AvalonSemiconductors/ci2406-bringup/README.md

# ci2406-bringup
Bring-up of CI2406 multi-project die.

[Documentation](https://avalonsemiconductors.github.io/CI2406/index.html)

[Tapeout repo](https://github.com/rejunity/ci2406-rej-pommedeterrible-tholin)
