AvalonSemiconductors/ci2406-bringup/AS1802/TestBoard/TestBoard.kicad_pcb

## KiCad design AS1802/TestBoard/TestBoard.kicad_pcb (2025-08-11)

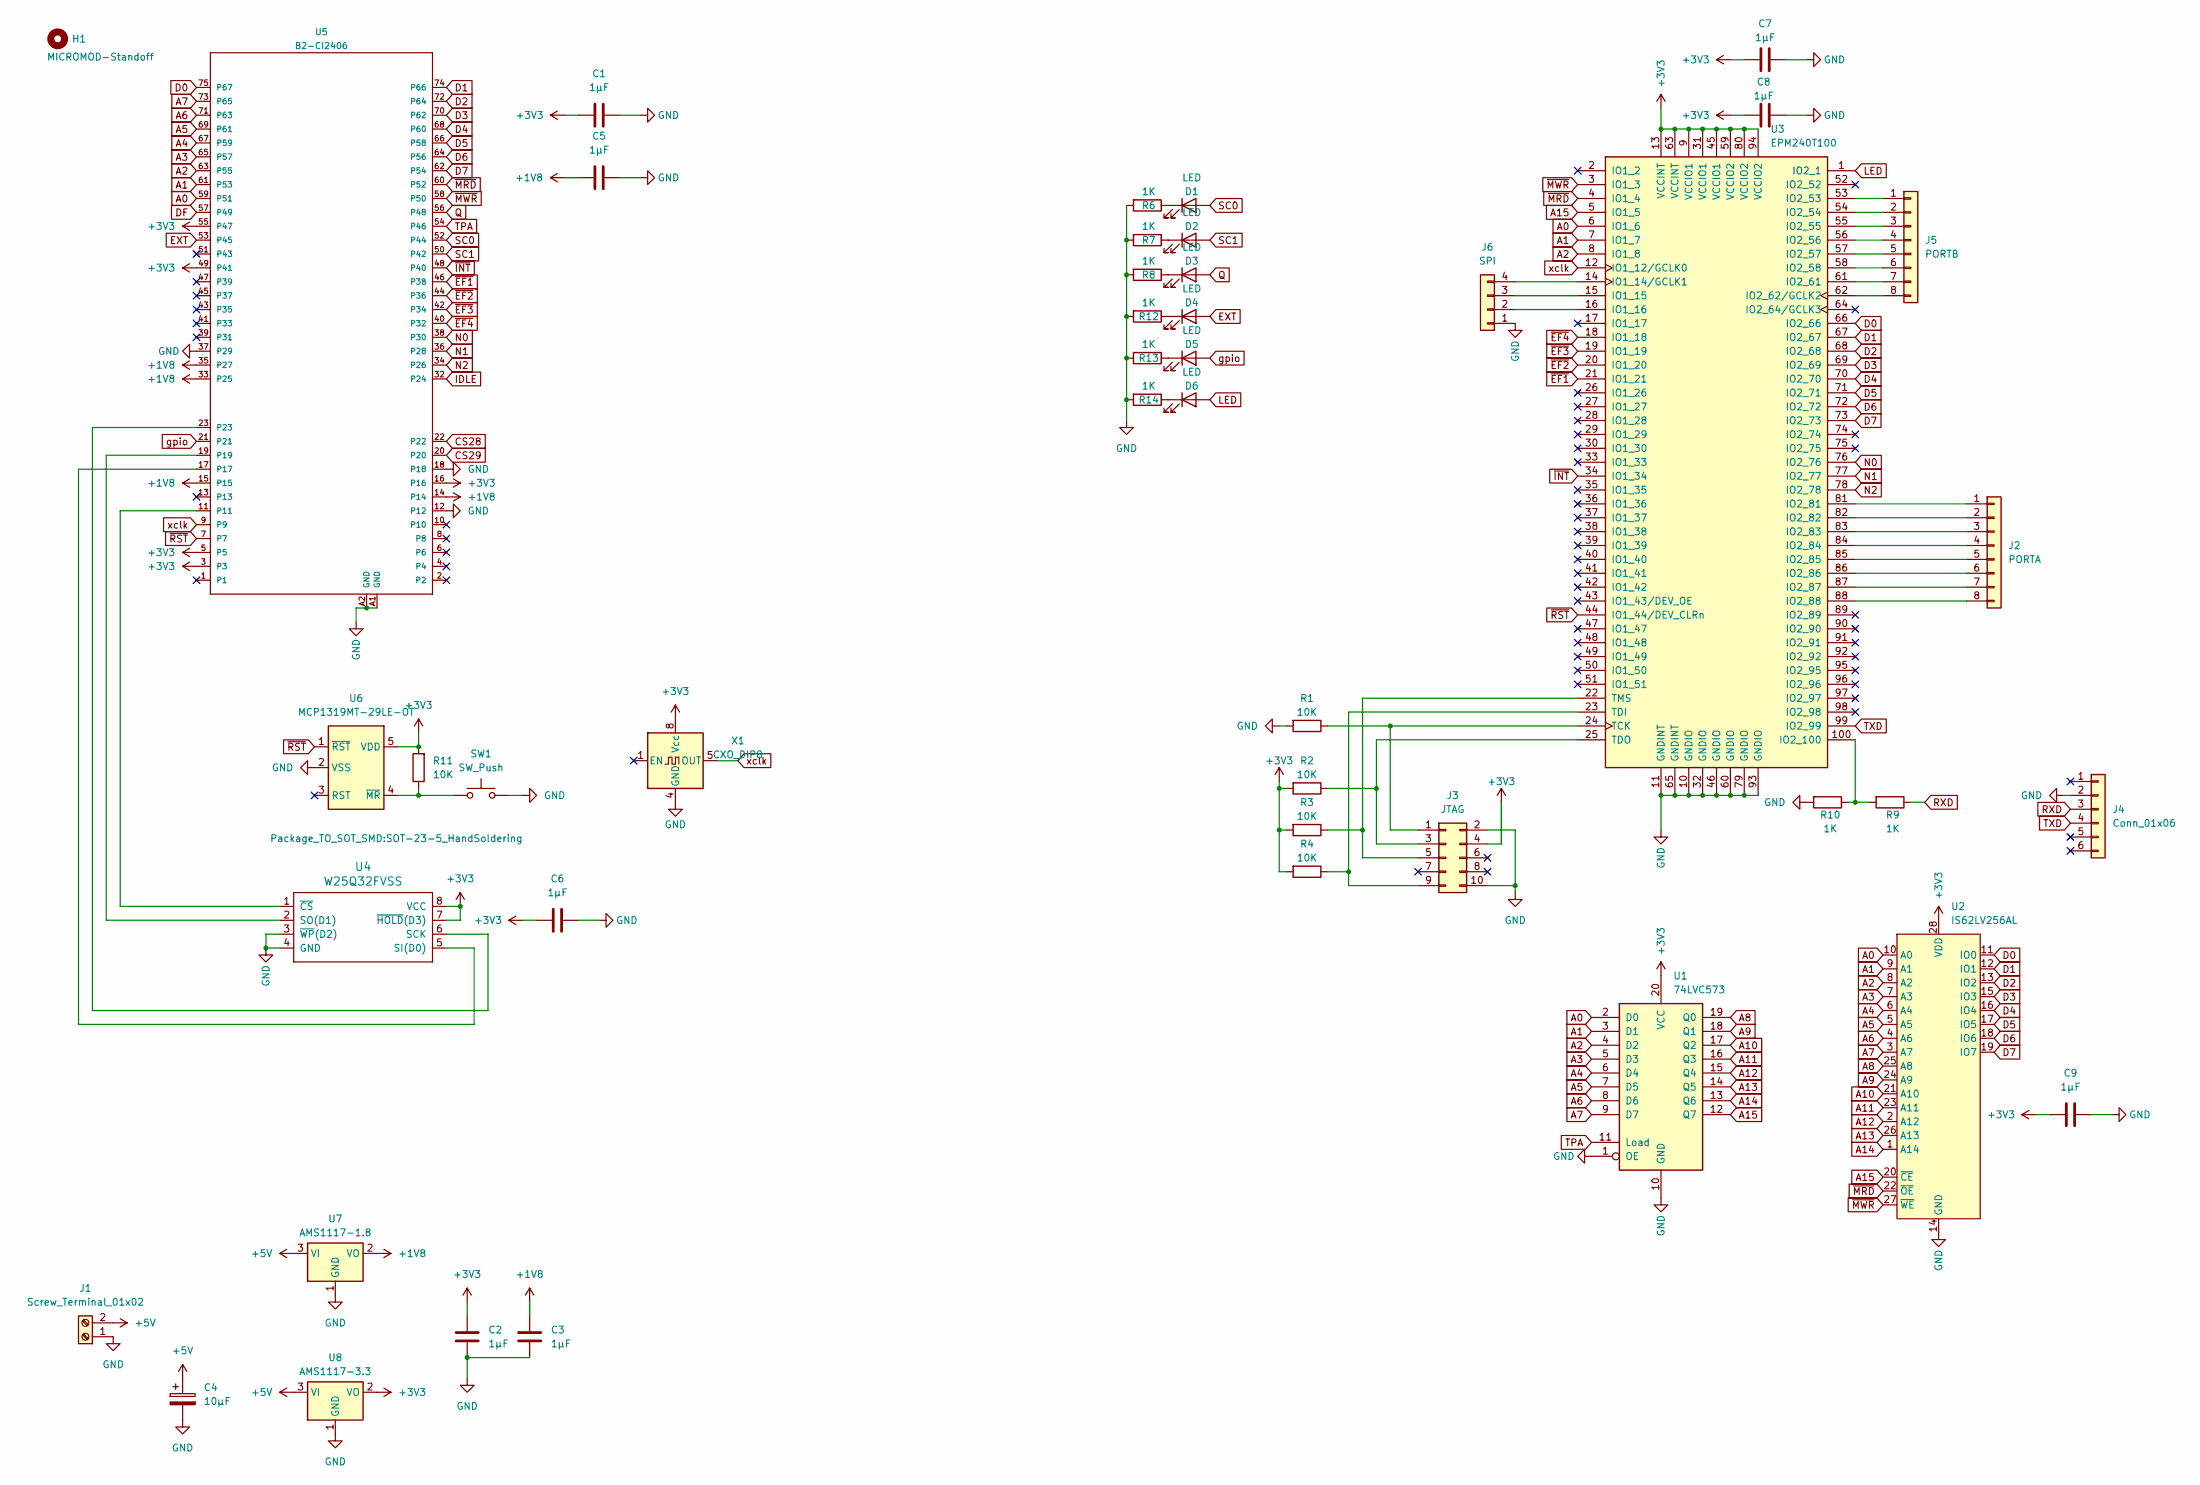
[picture p3: schematic TestBoard.kicad_sch]

Parts:
C1, C2, C3, C5, C6, C7, C8, C9: 1µF; C_0805_2012Metric_Pad1.18x1.45mm_HandSolder
C4: 10µF; CP_Radial_D4.0mm_P2.00mm
D1, D2, D3, D4, D5, D6: LED; LED_1206_3216Metric_Pad1.42x1.75mm_HandSolder
H1: MICROMOD-Standoff; MicroMod-Standoff
J1: Screw_Terminal_01x02; TerminalBlock_bornier-2_P5.08mm
J2: PORTA; PinHeader_1x08_P2.54mm_Vertical
J3: JTAG; PinHeader_2x05_P2.54mm_Vertical
J4: Conn_01x06; PinSocket_1x06_P2.54mm_Vertical
J5: PORTB; PinHeader_1x08_P2.54mm_Vertical
J6: SPI; PinHeader_1x04_P2.54mm_Vertical
R1, R2, R3, R4, R11: 10K; R_1206_3216Metric_Pad1.30x1.75mm_HandSolder
R6, R7, R8, R9, R10, R12, R13, R14: 1K; R_1206_3216Metric_Pad1.30x1.75mm_HandSolder
SW1: SW_Push; SW_PUSH_6mm
U1: 74LVC573; SO-20_12.8x7.5mm_P1.27mm
U2: IS62LV256AL; TSOP-I-28_11.8x8mm_P0.55mm-weird-pin-order
U3: EPM240T100; LQFP-100_14x14mm_P0.5mm
U4: W25Q32FVSS; DIP-8_W7.62mm; Part # W25Q32JVSSIQ
U5: B2-CI2406; M.2-CONNECTOR-E
U6: MCP1319MT-29LE-OT; SOT-23-5_HandSoldering
U7: AMS1117-1.8; SOT-223-3_TabPin2
U8: AMS1117-3.3; SOT-223-3_TabPin2
X1: CXO_DIP8; Oscillator_DIP-8

Connections:
+1V8: C3.2, C5.1, U5.14, U5.15, U5.33 (P25), U5.35 (P27), U7.2 (VO)
+3V3: C1.1, C2.2, C6.1, C7.1, C8.1, C9.1, J3.4, R2.2, R3.2, R4.2, R11.2, U1.20 (VCC), U2.28 (VDD), U3.9 (VCCIO1), U3.13 (VCCINT), U3.31 (VCCIO1), U3.45 (VCCIO1), U3.59 (VCCIO2), U3.63 (VCCINT), U3.80 (VCCIO2), U3.94 (VCCIO2), U4.7 (~HOLD(D3)), U4.8 (VCC), U5.3, U5.5, U5.16, U5.49 (P41), U5.55 (P47), U6.5 (VDD), U8.2 (VO), X1.8 (Vcc)
+5V: C4.1, J1.2, U7.3 (VI), U8.3 (VI)
A0: U1.2 (D0), U2.10 (A0), U3.6 (IO1_6), U5.59 (P51)
A1: U1.3 (D1), U2.9 (A1), U3.7 (IO1_7), U5.61 (P53)
A2: U1.4 (D2), U2.8 (A2), U3.8 (IO1_8), U5.63 (P55)
A3: U1.5 (D3), U2.7 (A3), U5.65 (P57)
A4: U1.6 (D4), U2.6 (A4), U5.67 (P59)
A5: U1.7 (D5), U2.5 (A5), U5.69 (P61)
A6: U1.8 (D6), U2.4 (A6), U5.71 (P63)
A7: U1.9 (D7), U2.3 (A7), U5.73 (P65)
A8: U1.19 (Q0), U2.25 (A8)
A9: U1.18 (Q1), U2.24 (A9)
A10: U1.17 (Q2), U2.21 (A10)
A11: U1.16 (Q3), U2.23 (A11)
A12: U1.15 (Q4), U2.2 (A12)
A13: U1.14 (Q5), U2.26 (A13)
A14: U1.13 (Q6), U2.1 (A14)
A15: U1.12 (Q7), U2.20 (~CE), U3.5 (IO1_5)
CS28: U5.22
CS29: U5.20
D0: U2.11 (IO0), U3.66 (IO2_66), U5.75 (P67)
D1: U2.12 (IO1), U3.67 (IO2_67), U5.74 (P66)
D2: U2.13 (IO2), U3.68 (IO2_68), U5.72 (P64)
D3: U2.15 (IO3), U3.69 (IO2_69), U5.70 (P62)
D4: U2.16 (IO4), U3.70 (IO2_70), U5.68 (P60)
D5: U2.17 (IO5), U3.71 (IO2_71), U5.66 (P58)
D6: U2.18 (IO6), U3.72 (IO2_72), U5.64 (P56)
D7: U2.19 (IO7), U3.73 (IO2_73), U5.62 (P54)
DF: U5.57 (P49)
EXT: D4.2 (A), U5.53 (P45)
GND: C1.2, C2.1, C3.1, C4.2, C5.2, C6.2, C7.2, C8.2, C9.2, J1.1, J3.2, J3.10, J4.2, J6.1, R1.2, R6.2, R7.2, R8.2, R10.2, R12.2, R13.2, R14.2, SW1.2, U1.1 (OE), U1.10 (GND), U2.14 (GND), U3.10 (GNDIO), U3.11 (GNDINT), U3.32 (GNDIO), U3.46 (GNDIO), U3.60 (GNDIO), U3.65 (GNDINT), U3.79 (GNDIO), U3.93 (GNDIO), U4.3 (~WP(D2)), U4.4 (GND), U5.12, U5.18, U5.37 (P29), U5.A1 (GND), U5.A2 (GND), U6.2 (VSS), U7.1 (GND), U8.1 (GND), X1.4 (GND)
IDLE: U5.32 (P24)
LED: D6.2 (A), U3.1 (IO2_1)
N0: U3.76 (IO2_76), U5.38 (P30)
N1: U3.77 (IO2_77), U5.36 (P28)
N2: U3.78 (IO2_78), U5.34 (P26)
unnamed: D1.1 (K), R6.1
unnamed: D2.1 (K), R7.1
unnamed: D3.1 (K), R8.1
unnamed: D4.1 (K), R12.1
unnamed: D5.1 (K), R13.1
unnamed: D6.1 (K), R14.1
unnamed: J2.1, U3.81 (IO2_81)
unnamed: J2.2, U3.82 (IO2_82)
unnamed: J2.3, U3.83 (IO2_83)
unnamed: J2.4, U3.84 (IO2_84)
unnamed: J2.5, U3.85 (IO2_85)
unnamed: J2.6, U3.86 (IO2_86)
unnamed: J2.7, U3.87 (IO2_87)
unnamed: J2.8, U3.88 (IO2_88)
unnamed: J3.1, R1.1, U3.24 (TCK)
unnamed: J3.3, R2.1, U3.25 (TDO)
unnamed: J3.5, R3.1, U3.22 (TMS)
unnamed: J3.9, R4.1, U3.23 (TDI)
unnamed: J5.1, U3.53 (IO2_53)
unnamed: J5.2, U3.54 (IO2_54)
unnamed: J5.3, U3.55 (IO2_55)
unnamed: J5.4, U3.56 (IO2_56)
unnamed: J5.5, U3.57 (IO2_57)
unnamed: J5.6, U3.58 (IO2_58)
unnamed: J5.7, U3.61 (IO2_61)
unnamed: J5.8, U3.62 (IO2_62/GCLK2)
unnamed: J6.2, U3.16 (IO1_16)
unnamed: J6.3, U3.15 (IO1_15)
unnamed: J6.4, U3.14 (IO1_14/GCLK1)
unnamed: R9.2, R10.1, U3.100 (IO2_100)
unnamed: U4.6 (SCK), U5.23
unnamed: U4.5 (SI(D0)), U5.17
unnamed: U4.2 (SO(D1)), U5.19
unnamed: U4.1 (~CS), U5.11
unnamed: R11.1, SW1.1, U6.4 (~MR)
Q: D3.2 (A), U5.56 (P48)
RXD: J4.3, R9.1
SC0: D1.2 (A), U5.52 (P44)
SC1: D2.2 (A), U5.50 (P42)
TPA: U1.11 (Load), U5.54 (P46)
TXD: J4.4, U3.99 (IO2_99)
gpio: D5.2 (A), U5.21
xclk: U3.12 (IO1_12/GCLK0), U5.9, X1.5 (OUT)
~EF1: U3.21 (IO1_21), U5.46 (P38)
~EF2: U3.20 (IO1_20), U5.44 (P36)
~EF3: U3.19 (IO1_19), U5.42 (P34)
~EF4: U3.18 (IO1_18), U5.40 (P32)
~INT: U3.34 (IO1_34), U5.48 (P40)
~MRD: U2.22 (~OE), U3.4 (IO1_4), U5.60 (P52)
~MWR: U2.27 (~WE), U3.3 (IO1_3), U5.58 (P50)
~RST: U3.44 (IO1_44/DEV_CLRn), U5.7, U6.1 (~RST)

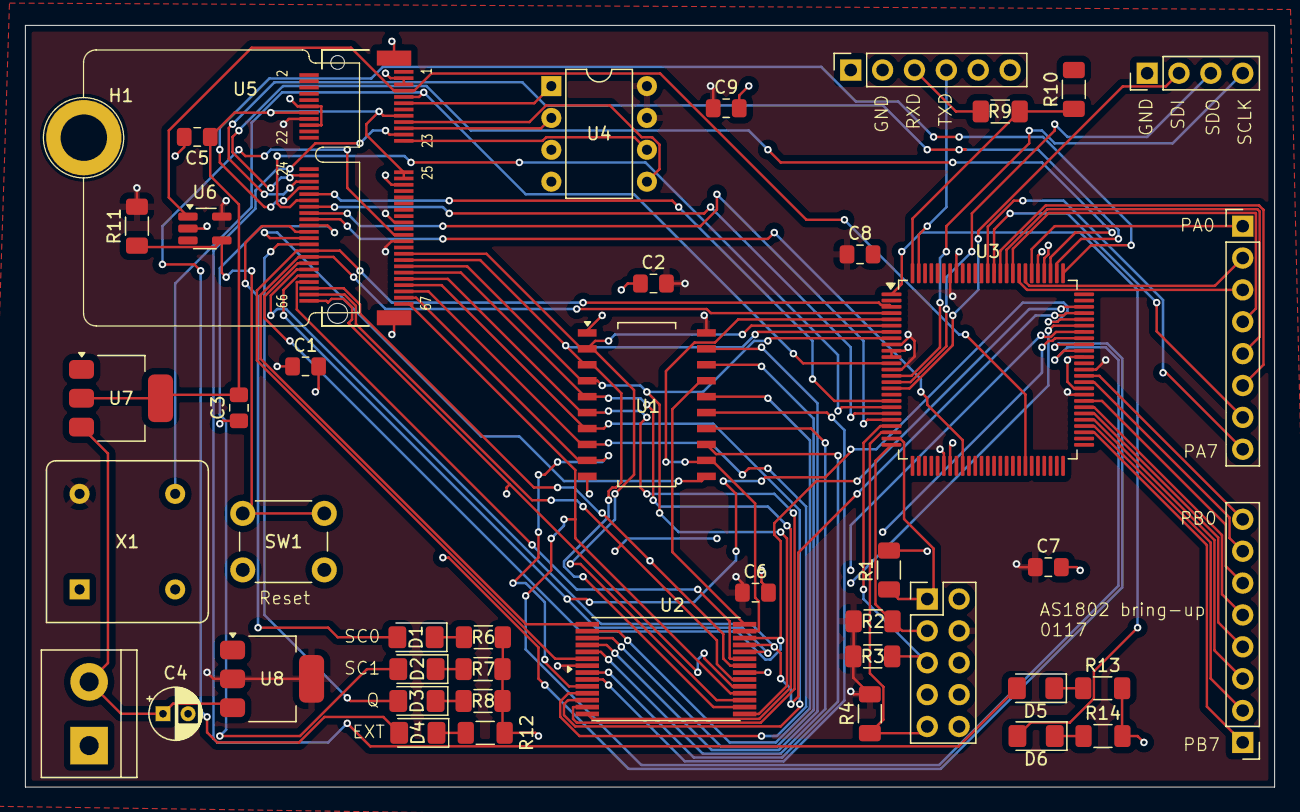
[picture p4: board TestBoard.kicad_pcb from above]

Board: 4 copper layers, 99.6 x 60.7 mm, 45 parts (0 on the bottom side), 84 nets.
