AvalonSemiconductors/ci2406-bringup/VLIW/TestHardwareVLIW/TestHardwareVLIW.kicad_pcb

## KiCad design VLIW/TestHardwareVLIW/TestHardwareVLIW.kicad_pcb (2025-06-21)

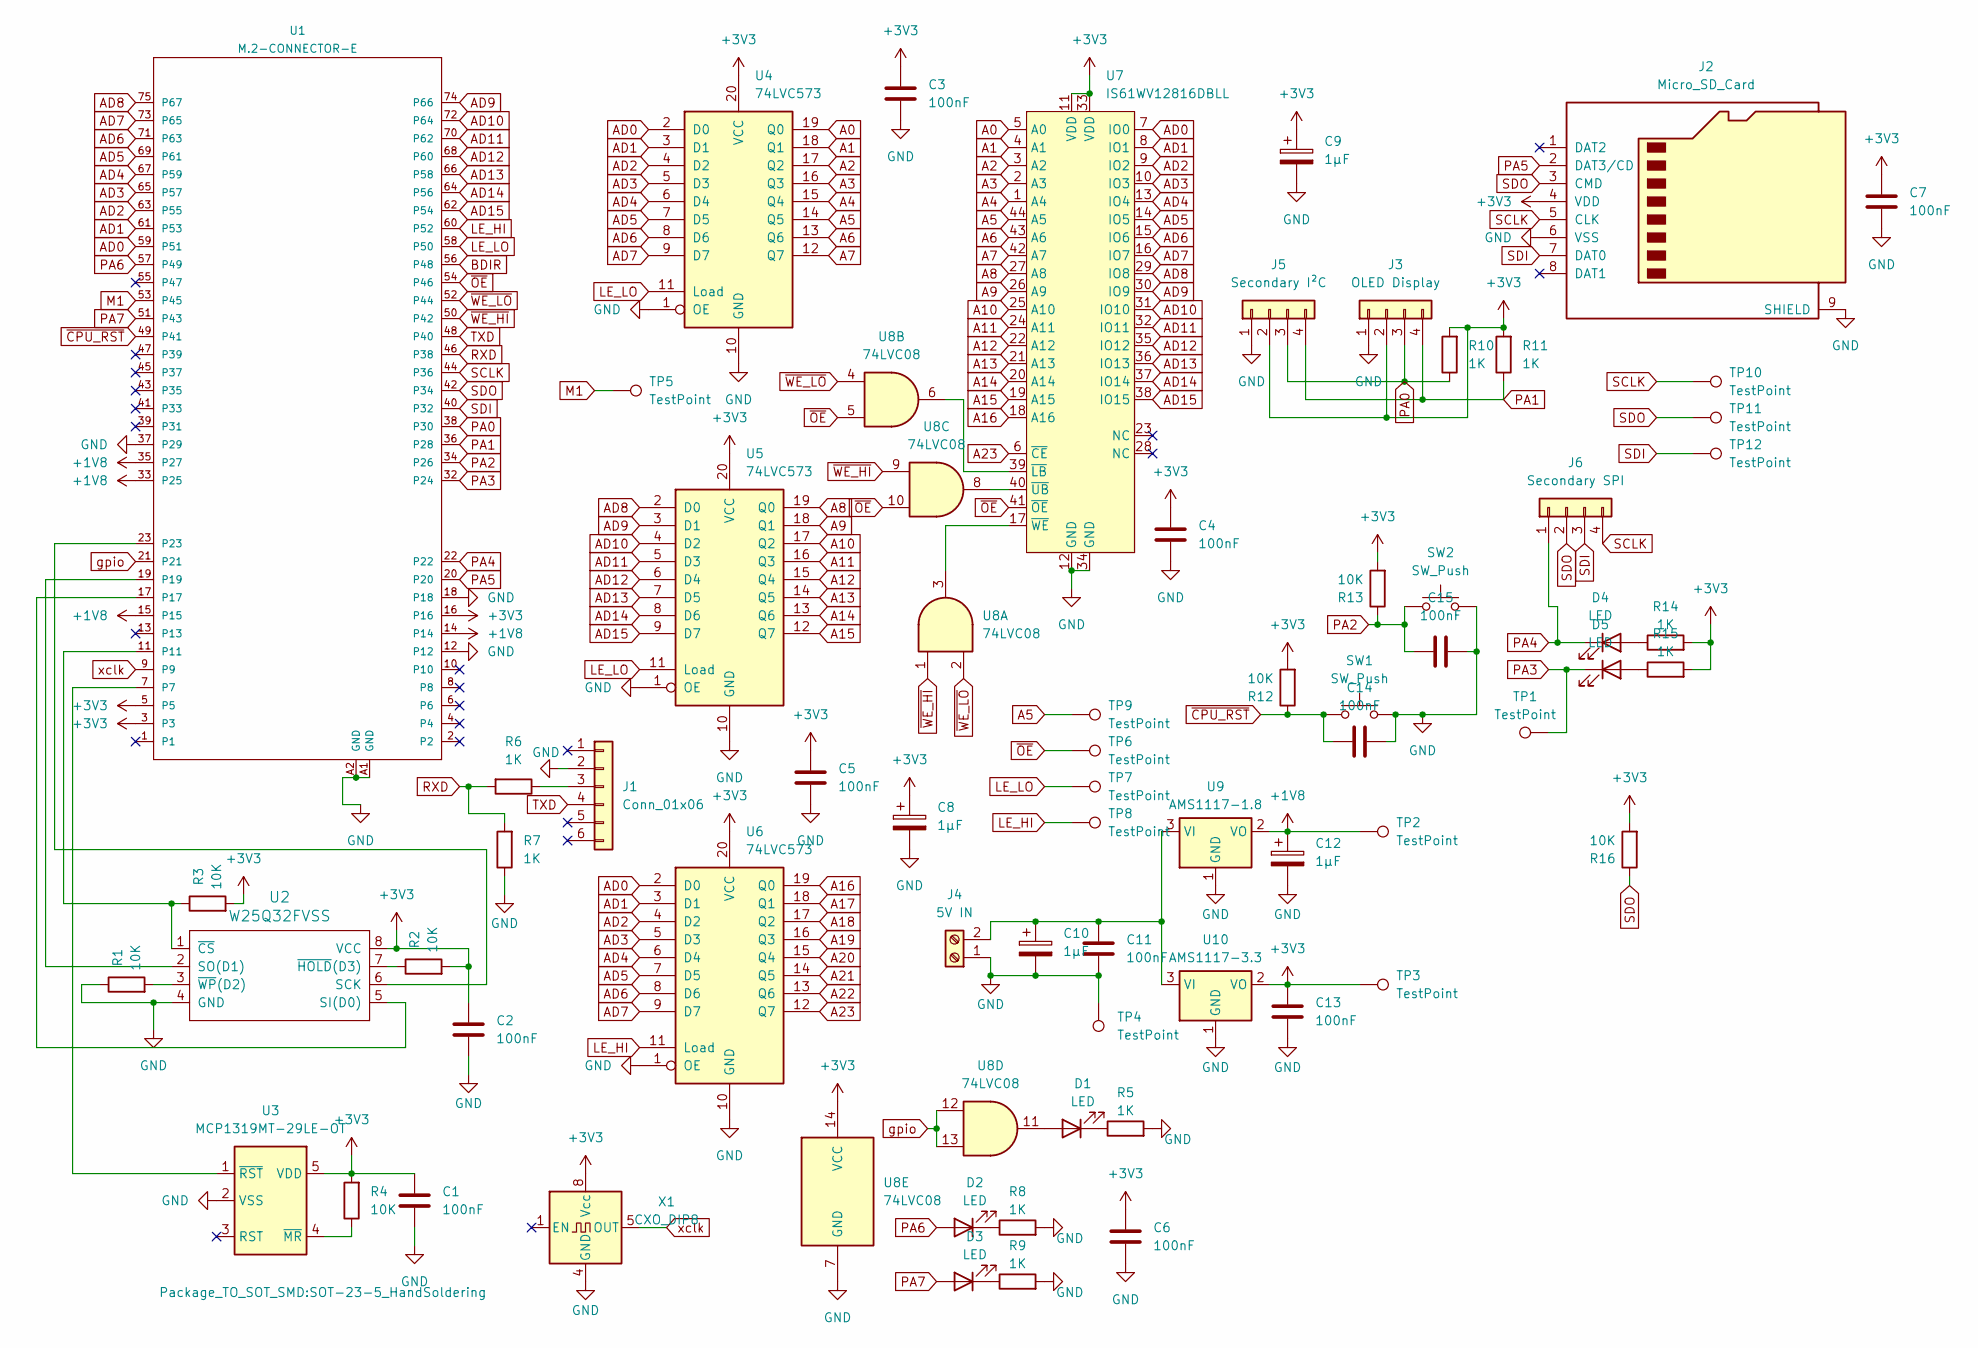
[picture p5: schematic TestHardwareVLIW.kicad_sch]

Parts:
C1, C2, C3, C4, C5, C6, C7, C11, C13, C14, C15: 100nF; C_0805_2012Metric_Pad1.18x1.45mm_HandSolder
C8, C9, C10, C12: 1µF; CP_Radial_D4.0mm_P2.00mm
D1, D2, D3, D4, D5: LED; LED_1206_3216Metric_Pad1.42x1.75mm_HandSolder
J1: Conn_01x06; PinSocket_1x06_P2.54mm_Vertical
J2: Micro_SD_Card; microSD_HC_Hirose_DM3AT-SF-PEJM5
J3: OLED Display; PinSocket_1x04_P2.54mm_Vertical
J4: 5V IN; TerminalBlock_bornier-2_P5.08mm
J5: Secondary I²C; PinSocket_1x04_P2.54mm_Vertical
J6: Secondary SPI; PinSocket_1x04_P2.54mm_Vertical
R1, R2, R3, R12, R13, R16: 10K; R_1206_3216Metric_Pad1.30x1.75mm_HandSolder; Part # RC0805FR-0710KL
R4: 10K; R_1206_3216Metric_Pad1.30x1.75mm_HandSolder
R5, R6, R7, R8, R9, R10, R11, R14, R15: 1K; R_1206_3216Metric_Pad1.30x1.75mm_HandSolder
SW1, SW2: SW_Push; SW_PUSH_6mm
TP1, TP2, TP3, TP4, TP5, TP6, TP7, TP8, TP9, TP10, TP11, TP12: TestPoint; TestPoint_Pad_D1.0mm
U1: M.2-CONNECTOR-E
U2: W25Q32FVSS; DIP-8_W7.62mm; Part # W25Q32JVSSIQ
U3: MCP1319MT-29LE-OT; SOT-23-5_HandSoldering
U4, U5, U6: 74LVC573; TSSOP-20_4.4x6.5mm_P0.65mm
U7: IS61WV12816DBLL; TSOP-II-44_10.16x18.41mm_P0.8mm
U8: 74LVC08; SO-14_3.9x8.65mm_P1.27mm
U9: AMS1117-1.8; SOT-223-3_TabPin2
U10: AMS1117-3.3; SOT-223-3_TabPin2
X1: CXO_DIP8; Oscillator_DIP-8

Connections:
+1V8: C12.1, TP2.1, U1.14, U1.15, U1.33 (P25), U1.35 (P27), U9.2 (VO)
+3V3: C1.1, C2.1, C3.1, C4.1, C5.1, C6.1, C7.1, C8.1, C9.1, C13.1, J2.4 (VDD), J3.2, J5.2, R2.2, R3.2, R4.2, R10.2, R11.2, R12.2, R13.2, R14.2, R15.2, R16.2, TP3.1, U1.3, U1.5, U1.16, U2.8 (VCC), U3.5 (VDD), U4.20 (VCC), U5.20 (VCC), U6.20 (VCC), U7.11 (VDD), U7.33 (VDD), U8.14 (VCC), U10.2 (VO), X1.8 (Vcc)
A0: U4.19 (Q0), U7.5 (A0)
A1: U4.18 (Q1), U7.4 (A1)
A2: U4.17 (Q2), U7.3 (A2)
A3: U4.16 (Q3), U7.2 (A3)
A4: U4.15 (Q4), U7.1 (A4)
A5: TP9.1, U4.14 (Q5), U7.44 (A5)
A6: U4.13 (Q6), U7.43 (A6)
A7: U4.12 (Q7), U7.42 (A7)
A8: U5.19 (Q0), U7.27 (A8)
A9: U5.18 (Q1), U7.26 (A9)
A10: U5.17 (Q2), U7.25 (A10)
A11: U5.16 (Q3), U7.24 (A11)
A12: U5.15 (Q4), U7.22 (A12)
A13: U5.14 (Q5), U7.21 (A13)
A14: U5.13 (Q6), U7.20 (A14)
A15: U5.12 (Q7), U7.19 (A15)
A16: U6.19 (Q0), U7.18 (A16)
A17: U6.18 (Q1)
A18: U6.17 (Q2)
A19: U6.16 (Q3)
A20: U6.15 (Q4)
A21: U6.14 (Q5)
A22: U6.13 (Q6)
A23: U6.12 (Q7), U7.6 (~CE)
AD0: U1.59 (P51), U4.2 (D0), U6.2 (D0), U7.7 (IO0)
AD1: U1.61 (P53), U4.3 (D1), U6.3 (D1), U7.8 (IO1)
AD2: U1.63 (P55), U4.4 (D2), U6.4 (D2), U7.9 (IO2)
AD3: U1.65 (P57), U4.5 (D3), U6.5 (D3), U7.10 (IO3)
AD4: U1.67 (P59), U4.6 (D4), U6.6 (D4), U7.13 (IO4)
AD5: U1.69 (P61), U4.7 (D5), U6.7 (D5), U7.14 (IO5)
AD6: U1.71 (P63), U4.8 (D6), U6.8 (D6), U7.15 (IO6)
AD7: U1.73 (P65), U4.9 (D7), U6.9 (D7), U7.16 (IO7)
AD8: U1.75 (P67), U5.2 (D0), U7.29 (IO8)
AD9: U1.74 (P66), U5.3 (D1), U7.30 (IO9)
AD10: U1.72 (P64), U5.4 (D2), U7.31 (IO10)
AD11: U1.70 (P62), U5.5 (D3), U7.32 (IO11)
AD12: U1.68 (P60), U5.6 (D4), U7.35 (IO12)
AD13: U1.66 (P58), U5.7 (D5), U7.36 (IO13)
AD14: U1.64 (P56), U5.8 (D6), U7.37 (IO14)
AD15: U1.62 (P54), U5.9 (D7), U7.38 (IO15)
BDIR: U1.56 (P48)
GND: C1.2, C2.2, C3.2, C4.2, C5.2, C6.2, C7.2, C8.2, C9.2, C10.2, C11.2, C12.2, C13.2, C14.1, C15.1, J1.2, J2.6 (VSS), J2.9 (SHIELD), J3.1, J4.1, J5.1, R1.1, R5.2, R7.1, R8.2, R9.2, SW1.2, SW2.2, TP4.1, U1.12, U1.18, U1.37 (P29), U1.A1 (GND), U1.A2 (GND), U2.4 (GND), U3.2 (VSS), U4.1 (OE), U4.10 (GND), U5.1 (OE), U5.10 (GND), U6.1 (OE), U6.10 (GND), U7.12 (GND), U7.34 (GND), U8.7 (GND), U9.1 (GND), U10.1 (GND), X1.4 (GND)
LE_HI: TP8.1, U1.60 (P52), U6.11 (Load)
LE_LO: TP7.1, U1.58 (P50), U4.11 (Load), U5.11 (Load)
M1: TP5.1, U1.53 (P45)
unnamed: D1.2 (A), U8.11
unnamed: D1.1 (K), R5.1
unnamed: D2.1 (K), R8.1
unnamed: D3.1 (K), R9.1
unnamed: D4.2 (A), R14.1
unnamed: D5.2 (A), R15.1
unnamed: J1.3, R6.1
unnamed: C10.1, C11.1, J4.2, U9.3 (VI), U10.3 (VI)
unnamed: U1.7, U3.1 (~RST)
unnamed: R3.1, U1.11, U2.1 (~CS)
unnamed: U1.17, U2.5 (SI(D0))
unnamed: U1.19, U2.2 (SO(D1))
unnamed: U1.23, U2.6 (SCK)
unnamed: R2.1, U2.7 (~HOLD(D3))
unnamed: R1.2, U2.3 (~WP(D2))
unnamed: R4.1, U3.4 (~MR)
unnamed: U7.39 (~LB), U8.6
unnamed: U7.40 (~UB), U8.8
unnamed: U7.17 (~WE), U8.3
PA0: J3.3, J5.3, R10.1, U1.38 (P30)
PA1: J3.4, J5.4, R11.1, U1.36 (P28)
PA2: C15.2, R13.1, SW2.1, U1.34 (P26)
PA3: D5.1 (K), TP1.1, U1.32 (P24)
PA4: D4.1 (K), J6.1, U1.22
PA5: J2.2 (DAT3/CD), U1.20
PA6: D2.2 (A), U1.57 (P49)
PA7: D3.2 (A), U1.51 (P43)
RXD: R6.2, R7.2, U1.46 (P38)
SCLK: J2.5 (CLK), J6.4, TP10.1, U1.44 (P36)
SDI: J2.7 (DAT0), J6.3, TP12.1, U1.40 (P32)
SDO: J2.3 (CMD), J6.2, R16.1, TP11.1, U1.42 (P34)
TXD: J1.4, U1.48 (P40)
gpio: U1.21, U8.12, U8.13
xclk: U1.9, X1.5 (OUT)
~CPU_RST: C14.2, R12.1, SW1.1, U1.49 (P41)
~OE: TP6.1, U1.54 (P46), U7.41 (~OE), U8.5, U8.10
~WE_HI: U1.50 (P42), U8.1, U8.9
~WE_LO: U1.52 (P44), U8.2, U8.4

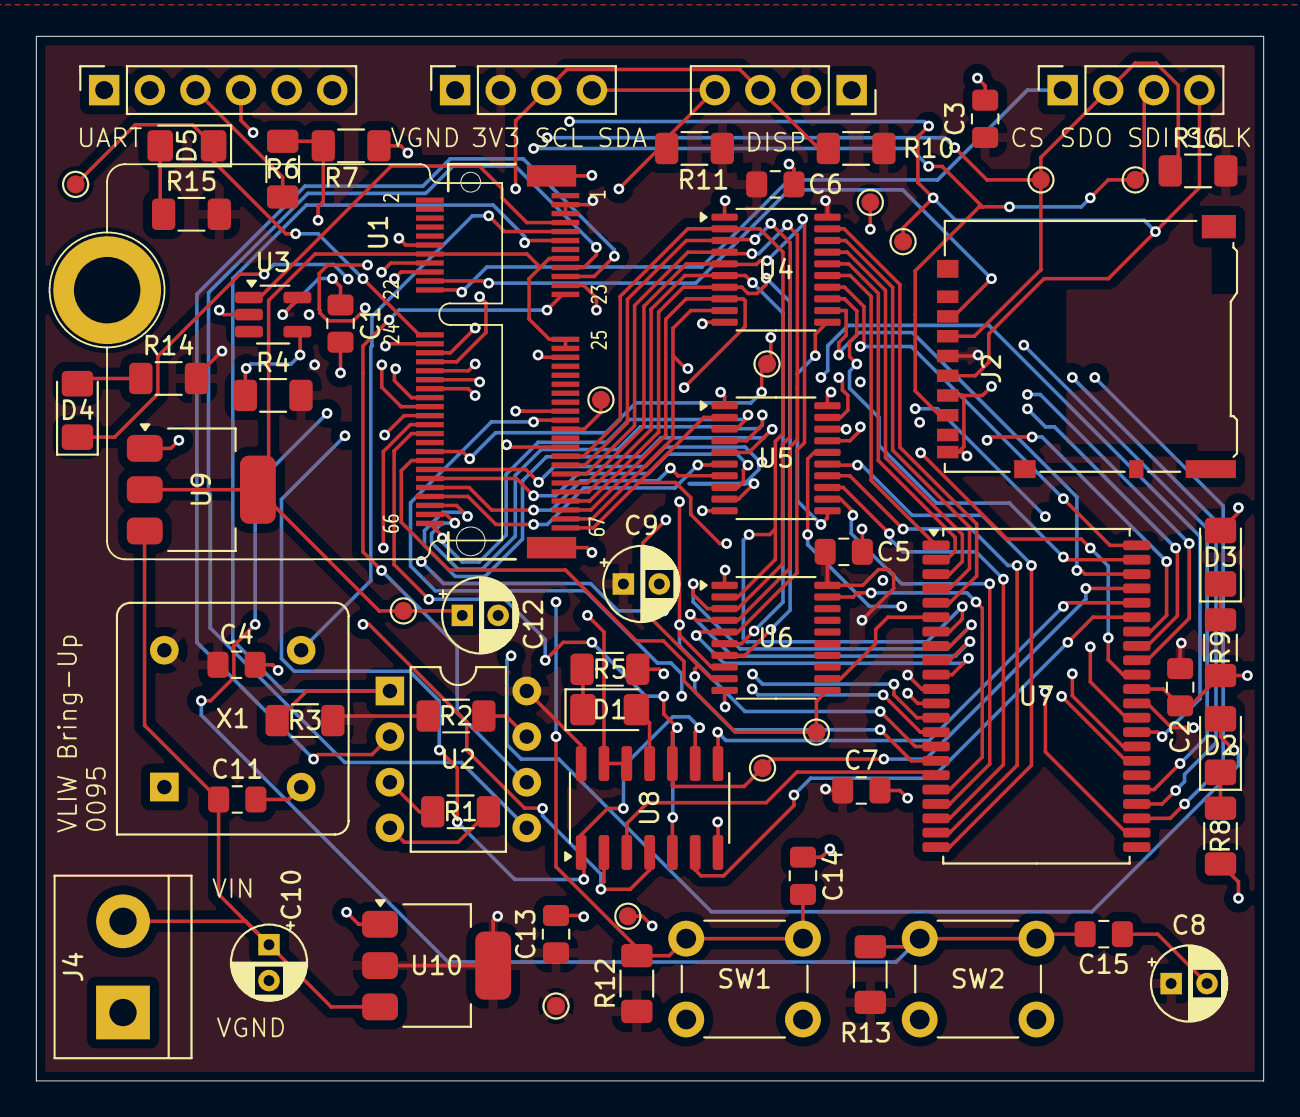
[picture p6: board TestHardwareVLIW.kicad_pcb from above]

Board: 4 copper layers, 68.3 x 58.2 mm, 67 parts (0 on the bottom side), 78 nets.
