AvalonSemiconductors/ci2406-bringup/VLIW/Programs/Test/pgmdata.h

const uint32_t pgm[] = {
	0xe8a2,0x0e03,0x8800,0x0fa2,0xffc0,0x005f,0xaec0,0x0000,0x0078,0x0000,0xe000,0x0001,0x0000,0x0060,0x0fc0,
	0x0000,0x0078,0x0000,0xe000,0x0001,0x0000,0x0060,0x0fc0,0x0000,0x0078,0x0000,0xe000,0x0001,0x0000,0x0060,0x0fc0,
	0x0000,0x0078,0x0000,0xe000,0x0001,0x0000,0x0060,0x0fc0,0x0000,0xd839,0x76ed,0xe000,0x0001,0x0000,0x0780,0x0000,
	0x0000,0xf0a2,0xfe03,0x8bff,0x0062,0x0f84,0x0a20,0x003f,0x3fe0,0x20a2,0x0202,0x8800,0x0882,0x0810,0x04c0,0x0f82,
	0x8003,0x0078,0x0000,0x8800,0x0082,0x12c4,0x04c0,0x8f82,0x8003,0x184c,0x58f8,0xe000,0x0001,0x0000,0x84c0,0x0f9d,
	0x0008,0x80a2,0x0202,0x8800,0x0a02,0x6680,0x0784,0x0000,0x0000,0xe00a,0x80ed,0x1800,0xc780,0x00f3,0x0780,0x0000,
	0x4000,0xe00a,0x80ed,0x1800,0xc780,0x0583,0x0780,0x0000,0x4000,0xe00a,0x80ed,0x1800,0xc780,0x0d2b,0x0780,0x0000,
	0x4000,0x1005,0x2cec,0xe000,0x0001,0x0000,0x0780,0x0000,0x0000,0x80a2,0x3002,0x891b,0x0a02,0x0008,0x0780,0x0000,
	0x0000,0xe00a,0x80ed,0x1800,0xc780,0x00cb,0x0780,0x0000,0x4000,0x50a2,0xd002,0x88cb,0x0942,0x0008,0x0440,0x0288,
	0x8000,0xe00a,0x80ed,0x1800,0xc780,0x01e3,0x0780,0x0000,0x4000,0x80a2,0xdc02,0x891b,0x0a02,0x0008,0x0780,0x0000,
	0x0000,0xe00a,0x80ed,0x1800,0xc780,0x00ab,0x0780,0x0000,0x4000,0x50a2,0xf002,0x88cb,0x0942,0x0008,0x0440,0x0288,
	0x8000,0xe00a,0x80ed,0x1800,0xc780,0x01c3,0x0780,0x0000,0x4000,0xe00a,0x80ed,0x1800,0xc780,0x0253,0x0780,0x0000,
	0x4000,0xe00a,0x80ed,0x1800,0xc780,0x165b,0x0780,0x0000,0x4000,0xc0a2,0x0202,0x8800,0x0b02,0x6640,0x84c4,0x061d,
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
	0x0000,0x0844,0x08f5,0xe000,0x0001,0x0000,0x0780,0x0000,0x0000,0x7844,0x10f4,0x0800,0xd7a0,0x0083,0x0060,0x0f00,
	0x0000,0xe882,0x40f5,0xe000,0x0001,0x0000,0x0780,0x0000,0x0000,0x984c,0x08f5,0xe000,0x0001,0x0000,0x0780,0x0000,
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
	'C','h','i','r','p','!'
};
const uint32_t pgm_len = 9097;
