AvalonSemiconductors/ci2406-bringup/AS1802/Programs/BringUpSample/pgmdata.h

const uint32_t pgm[] = {
	0xf8c4,0xa264,0x00f8,0xf8b2,0xb980,0x00f8,0xf8a9,0x5955,0xf819,0x5901,0x80f8,0xf859,0xa906,0xfff8,0x1959,
	0xf859,0xb17f,0xfff8,0xe1a1,0x0af8,0xf8b3,0xa328,0x02f8,0x03a9,0x3213,0x5937,0x30d2,0xc02f,0x3c07,0x00f8,0xbbab,
	0xdef8,0x01fc,0x403a,0x2bc4,0x3a9b,0x8b3e,0x3e3a,0x5131,0x307b,0x7a52,0x00f8,0xf8a9,0xb980,0xfb09,0x5980,0x02f8,
	0xf8a9,0x5961,0x3a30,0x37c4,0xd064,0x6430,0x7389,0x7380,0x7390,0x7394,0x7385,0x7395,0x92f8,0xf8a0,0xb000,0x60d0,
	0xb5f0,0xf060,0x60a5,0xb4f0,0xf060,0x60b0,0xa0f0,0xf060,0xd0a9,0x6a30,0x02f8,0x03a9,0xb423,0xf6f6,0xf6f6,0x3ffc,
	0xf8a5,0x7c00,0xb50a,0x5905,0x37c4,0xd2a6,0xfa94,0xfc0f,0xa53f,0x00f8,0x0a7c,0x05b5,0xc459,0xb737,0x84d2,0x01ff,
	0x3aa4,0xd692,0x60f8,0xf8b3,0xa304,0xaa43,0xba43,0xab43,0xbb43,0x00f8,0xe3b8,0xf688,0x3ba8,0xf8ef,0xa30b,0xf48a,
	0x1353,0x749a,0x1353,0x748b,0x1353,0x749b,0x1353,0x7498,0x8a53,0xaafe,0x7e9a,0x8bba,0xab7e,0x7e9b,0x98bb,0xb87e,
	0xca88,0xd400,0xd6e1,0x00c0,0xf8c2,0xb360,0x0ff8,0xf8a3,0xe300,0x7373,0x7373,0x7373,0x7373,0xc0e1,0x8901,0x00f8,
	0xf8af,0xbd60,0x03f8,0x4dad,0x80fa,0x01c2,0xf84f,0xbc60,0x00f8,0x0cac,0xfffb,0x01fc,0x1c5c,0xfb0c,0x7cff,0x5c00,
	0x0c1c,0xfffb,0x007c,0x1c5c,0xfb0c,0x7cff,0x5c00,0x01f8,0x1daf,0x1d1d,0xfa0d,0xc280,0x7d01,0x04f8,0xf8ac,0xbc60,
	0xfb0c,0xfcff,0x5c01,0x0c1c,0xfffb,0x007c,0x1c5c,0xfb0c,0x7cff,0x5c00,0x0c1c,0xfffb,0x007c,0x8f5c,0x01fb,0x8faf,
	0xf8c8,0xaf00,0x7383,0x7393,0x01c0,0xf807,0xbf04,0x60f8,0xf8bd,0xad00,0x00f8,0xf8bc,0xacc2,0x60f8,0xf8b3,0xa309,
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
	0xbeae,0xa8af,0xaab8,0xabba,0xf8bb,0xa430,0xfe88,0x98a8,0xb87e,0x7e8a,0x9aaa,0xba7e,0x7e8b,0x9bab,0xbb7e,0x60f8,
	0xf8b2,0xa214,0xfe02,0x1252,0x7e02,0x1252,0x7e02,0x1252,0x7e02,0x1252,0x7e02,0x1252,0x7e02,0x8d52,0xad7e,0x7e9d,
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
	'C','h','i','r','p','!'
};
const uint32_t pgm_len = 2870;
