AvalonSemiconductors/ci2406-bringup/AS1802/Programs/BringUpSample/test.asm

R0 equ 0
R1 equ 1
R2 equ 2
R3 equ 3
R4 equ 4
R5 equ 5
R6 equ 6
R7 equ 7
R8 equ 8
R9 equ 9
R10 equ 10
R11 equ 11
R12 equ 12
R13 equ 13
R14 equ 14
R15 equ 15

; Memory locations
MIN00 equ 6000h
MIN01 equ 6001h
MIN02 equ 6002h
MIN03 equ 6003h
MIN10 equ 6004h
MIN11 equ 6005h
MIN12 equ 6006h
MIN13 equ 6007h
MRES0 equ 6008h
MRES1 equ 6009h
MRES2 equ 600Ah
MRES3 equ 600Bh
MRES4 equ 600Ch
MRES5 equ 600Dh
MRES6 equ 600Eh
MRES7 equ 600Fh

TEMP0 equ 6010h
TEMP1 equ 6011h
TEMP2 equ 6012h
TEMP3 equ 6013h
DIN00 equ 6014h
DIN01 equ 6015h
DIN02 equ 6016h
DIN03 equ 6017h
DIN04 equ 6018h
DIN05 equ 6019h
SQRT_RESULT0 equ 601Ah
SQRT_RESULT1 equ 601Bh
SQRT_RESULT2 equ 601Ch
SQRT_RESULT3 equ 601Dh

IO_PORTA equ 0
IO_UART equ 2

; Register conventions
; R2 always points to UART_WAIT subroutine for fast access
; R9 points to memory-mapped IO locations (R9.1 never needs to be reloaded as a result)
; R0 is the default PC
; R1 is the default SP
; R6 is the standard subroutine PC (for any other routine than SPI_WAIT)
; Leaving R3, R4, R5, R7 and R8 - R15 free
; R3, R4, R5, R7 and R9.1 need to be pushed to stack if used by subroutine
	
	org 0
START:
	NOP
	LDI UART_WAIT&255
	PLO R2
	LDI UART_WAIT>>8
	PHI R2
	LDI 80h
	PHI R9
	LDI IO_PORTA
	PLO R9
	
	ldi 55h
	str R9
	inc R9
	ldi 1
	str R9
	ldi 128
	str R9
	ldi 6
	plo R9
	ldi 255
	str R9
	inc R9
	str R9
	
	; Stack at 0x7FFF
	LDI 7Fh
	PHI R1
	LDI 255
	PLO R1
	SEX R1
	
	; Print Hello Message
	LDI HELLO_TEXT>>8
	PHI R3
	LDI HELLO_TEXT&255
	PLO R3
	LDI 02h
	PLO R9
PRINT_LOOP:
	LDN R3
	INC R3
	BZ PRINT_LOOP_DONE
	STR R9
	SEP R2
	BR PRINT_LOOP
PRINT_LOOP_DONE:

	; For several reasons, we want all subroutines to be defined before the main program code
	; So let’s do that, and branch to the rest of the program here
	LBR TEST_MUL

	; Infinite loop of blinking Q
END:
	LDI 0
	PLO R11
	PHI R11
del_loop:
	LDI 222
inner_del_loop:
	ADI 1
	BNZ inner_del_loop
	NOP
	
	DEC R11
	GHI R11
	BNZ del_loop
	GLO R11
	BNZ del_loop
	
	BQ clr_q
	SEQ
	BR s_q
clr_q:
	REQ
s_q:

	LDI 0
	PLO R9
	LDI 128
	PHI R9
	LDN R9
	XRI 128
	STR R9
	LDI 2
	PLO R9
	LDI 'a'
	STR R9
	
	BR END

	; Wait for UART TX complete subroutine
UART_WAIT:
	NOP
	B4 UART_WAIT
	SEP R0
	BR UART_WAIT

	; Display a string of memory as hex
	; R3 = Pointer to most-significant byte
	; R4.0 = Length of string
PRINT_HEX:
	GLO R9
	STXD
	GLO R0
	STXD
	GHI R0
	STXD
	GHI R4
	STXD
	GLO R5
	STXD
	GHI R5
	STXD
	LDI PRINT_HEX_LOOP&255
	PLO R0
	LDI PRINT_HEX_LOOP>>8
	PHI R0
	SEP R0
	IRX
	LDX
	PHI R5
	IRX
	LDX
	PLO R5
	IRX
	LDX
	PHI R4
	IRX
	LDX
	PHI R0
	IRX
	LDX
	PLO R0
	IRX
	LDX
	PLO R9
	SEP R0
	BR PRINT_HEX
PRINT_HEX_LOOP:
	LDI IO_UART
	PLO R9
	LDN R3
	DEC R3
	PHI R4
	SHR
	SHR
	SHR
	SHR
	ADI HEX_DIGITS&255
	PLO R5
	LDI 0
	ADCI HEX_DIGITS>>8
	PHI R5
	LDN R5
	STR R9
weh0:
	NOP
	B4 weh0
	SEP R2
	GHI R4
	ANI 15
	ADI HEX_DIGITS&255
	PLO R5
	LDI 0
	ADCI HEX_DIGITS>>8
	PHI R5
	LDN R5
	STR R9
weh1:
	NOP
	B4 weh1
	SEP R2
	GLO R4
	SMI 1
	PLO R4
	BNZ PRINT_HEX_LOOP
	SEP R6

MUL_8x32:
	LDI MIN10>>8
	PHI R3
	LDI MIN10&255
	PLO R3
	LDA R3
	PLO R10
	LDA R3
	PHI R10
	LDA R3
	PLO R11
	LDA R3
	PHI R11
	LDI 0
	PHI R8
	SEX R3
MUL_8x32_LOOP:
	GLO R8
	SHR
	PLO R8
	BNF MUL_8x32_NO_CARRY
	LDI MRES3&255
	PLO R3
	GLO R10
	ADD
	STR R3
	INC R3
	GHI R10
	ADC
	STR R3
	INC R3
	GLO R11
	ADC
	STR R3
	INC R3
	GHI R11
	ADC
	STR R3
	INC R3
	GHI R8
	ADC
	STR R3
MUL_8x32_NO_CARRY:
	GLO R10
	SHL
	PLO R10
	GHI R10
	SHLC
	PHI R10
	GLO R11
	SHLC
	PLO R11
	GHI R11
	SHLC
	PHI R11
	GHI R8
	SHLC
	PHI R8
	GLO R8
	LBNZ MUL_8x32_LOOP
	SEX R1
	SEP R6
	LBR MUL_8x32

ZERO_MUL_RES:
	LDI MRES7>>8
	PHI R3
	LDI MRES7&255
	PLO R3
	LDI 0
	SEX R3
	STXD
	STXD
	STXD
	STXD
	STXD
	STXD
	STXD
	STXD
	SEX R1
	LBR ZERO_MUL_RES_DONE

	; R15.0 stores sign of result
MUL_32x32_SIGNED:
	LDI 0
	PLO R15
	LDI MIN03>>8
	PHI R13
	LDI MIN03&255
	PLO R13
	LDA R13
	ANI 128
	LBZ MUL_32x32_NOT_NEG_A
	LDI MIN00>>8
	PHI R12
	LDI MIN00&255
	PLO R12
	LDN R12
	XRI 255
	ADI 1
	STR R12
	INC R12
	LDN R12
	XRI 255
	ADCI 0
	STR R12
	INC R12
	LDN R12
	XRI 255
	ADCI 0
	STR R12
	INC R12
	LDN R12
	XRI 255
	ADCI 0
	STR R12
	LDI 1
	PLO R15
MUL_32x32_NOT_NEG_A:
	INC R13
	INC R13
	INC R13
	LDN R13
	ANI 128
	LBZ MUL_32x32_NOT_NEG_B
	LDI MIN10&255
	PLO R12
	LDI MIN10>>8
	PHI R12
	LDN R12
	XRI 255
	ADI 1
	STR R12
	INC R12
	LDN R12
	XRI 255
	ADCI 0
	STR R12
	INC R12
	LDN R12
	XRI 255
	ADCI 0
	STR R12
	INC R12
	LDN R12
	XRI 255
	ADCI 0
	STR R12
	GLO R15
	XRI 1
	PLO R15
MUL_32x32_NOT_NEG_B:
	
	GLO R15
	LSKP
MUL_32x32_UNSIGNED:
	LDI 0
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
	ANI 128
	LBNZ SQRT_TEST_SKIP
	DEC R3
	DEC R3
	DEC R3

	LDI 's'
	STR R9
	SEP R2
	LDI 'q'
	STR R9
	SEP R2
	LDI 'r'
	STR R9
	SEP R2
	LDI 't'
	STR R9
	SEP R2
	LDI '('
	STR R9
	SEP R2
	LDI PRINT_FIXED>>8
	PHI R6
	LDI PRINT_FIXED&255
	PLO R6
	SEP R6
	LDI ')'
	STR R9
	SEP R2
	LDI '='
	STR R9
	SEP R2

	LDI SQRT>>8
	PHI R6
	LDI SQRT&255
	PLO R6
	SEP R6
	LDI SQRT_RESULT0>>8
	PHI R3
	LDI SQRT_RESULT0&255
	PLO R3
	LDI PRINT_FIXED>>8
	PHI R6
	LDI PRINT_FIXED&255
	PLO R6
	SEP R6
	LDI 13
	STR R9
	SEP R2
	LDI 10
	STR R9
	SEP R2

SQRT_TEST_SKIP:
	GLO R5
	ADI 4
	PLO R5
	SMI 28
	LBNZ SQRT_TEST_LOOP
	
FROM_RAM:
	LDI RAMCODE>>8
	PHI R3
	LDI RAMCODE&255
	PLO R3
	LDI 70h
	PHI R4
	LDI 00h
	PLO R4
FROM_RAM_SETUP_LOOP:
	LDA R3
	STR R4
	INC R4
	GLO R3
	XRI BEGIN_DATA&255
	BNZ FROM_RAM_SETUP_LOOP
	GHI R3
	XRI BEGIN_DATA>>8
	BNZ FROM_RAM_SETUP_LOOP
	
	LDI 70h
	PHI R4
	LDI 00h
	PLO R4
	SEP R4
	
	LBR END

	align 256
RAMCODE:
	LDI 70h ; +0h
	PHI R3 ; +2h
	LDI 14h ; +3h
	PLO R3 ; +5h
	LDI IO_UART ; +6h
	PLO R9 ; +8h
	LDA R3 ; +9h
	LBZ 7013h ; +Ah
	STR R9 ; +Dh
weh5:
	B4 weh5 ; +Eh
	LBR 7009h ; +10h
	; +13h
	SEP R0
	; +14h
	db 10
	db 13
	db 'Hi from RAM!'
	db 13
	db 10
	db 13
	db 10
	db 0
BEGIN_DATA:
	db 0
	; End of code, begin data
HELLO_TEXT:
	db 10
	db 13
	db 'Hello from CI2406!'
	db 13
	db 10
	db 0
HEX_DIGITS:
	db '0123456789ABCDEF'
PRINTINT32_DIVS:
	; -1000000000
	db 00h, 36h, 65h, 0C4h
	; -100000000
	db 00h, 1Fh, 0Ah, 0FAh
	; -10000000
	db 80h, 69h, 67h, 0FFh
	; -1000000
	db 0C0h, 0BDh, 0F0h, 0FFh
	; -100000
	db 60h, 79h, 0FEh, 0FFh
	; -10000
	db 0F0h, 0D8h, 0FFh, 0FFh
	; -1000
	db 18h, 0FCh, 0FFh, 0FFh
	; -100
	db 9Ch, 0FFh, 0FFh, 0FFh
	; -10
	db 0F6h, 0FFh, 0FFh, 0FFh
	; -1
	db 0FFh, 0FFh, 0FFh, 0FFh
PRINTINT64_DIVS:
	; -1000000000000000000
	db 00h, 00h, 9Ch, 58h, 4Ch, 49h, 1Fh, 0F2h
	; -100000000000000000
	db 00h, 00h, 76h, 0A2h, 87h, 0BAh, 9Ch, 0FEh
	; -10000000000000000
	db 00h, 00h, 3Fh, 90h, 0Dh, 79h, 0DCh, 0FFh
	; -1000000000000000
	db 00h, 80h, 39h, 5Bh, 81h, 72h, 0FCh, 0FFh
	; -100000000000000
	db 00h, 0C0h, 85h, 0EFh, 0Ch, 0A5h, 0FFh, 0FFh
	; -10000000000000
	db 00h, 60h, 8Dh, 0B1h, 0E7h, 0F6h, 0FFh, 0FFh
	; -1000000000000
	db 00h, 0F0h, 5Ah, 2Bh, 17h, 0FFh, 0FFh, 0FFh
	; -100000000000
	db 00h, 18h, 89h, 0B7h, 0E8h, 0FFh, 0FFh, 0FFh
	; -10000000000
	db 00h, 1Ch, 0F4h, 0ABh, 0FDh, 0FFh, 0FFh, 0FFh
	; -1000000000
	db 00h, 36h, 65h, 0C4h, 0FFh, 0FFh, 0FFh, 0FFh
	; -100000000
	db 00h, 1Fh, 0Ah, 0FAh, 0FFh, 0FFh, 0FFh, 0FFh
	; -10000000
	db 80h, 69h, 67h, 0FFh, 0FFh, 0FFh, 0FFh, 0FFh
	; -1000000
	db 0C0h, 0BDh, 0F0h, 0FFh, 0FFh, 0FFh, 0FFh, 0FFh
	; -100000
	db 60h, 79h, 0FEh, 0FFh, 0FFh, 0FFh, 0FFh, 0FFh
	; -10000
	db 0F0h, 0D8h, 0FFh, 0FFh, 0FFh, 0FFh, 0FFh, 0FFh
	; -1000
	db 18h, 0FCh, 0FFh, 0FFh, 0FFh, 0FFh, 0FFh, 0FFh
	; -100
	db 9Ch, 0FFh, 0FFh, 0FFh, 0FFh, 0FFh, 0FFh, 0FFh
	; -10
	db 0F6h, 0FFh, 0FFh, 0FFh, 0FFh, 0FFh, 0FFh, 0FFh
	; -1
	db 0FFh, 0FFh, 0FFh, 0FFh, 0FFh, 0FFh, 0FFh, 0FFh
FIXED_TEST_NUMS:
	db 008h, 0D0h, 02Bh, 001h, 0ADh, 039h, 000h, 000h
	db 012h, 08Dh, 095h, 0FAh, 0FFh, 063h, 010h, 000h
	db 03Fh, 024h, 003h, 000h, 000h, 000h, 002h, 000h
	db 0ADh, 0DFh, 002h, 000h, 0ADh, 0DFh, 002h, 000h
