AvalonSemiconductors/ci2406-bringup/(commit log)

2025-08-11 VLIW ext4 progress
    [TestBoard.kicad_pcb, TestBoard.kicad_sch]
2025-10-02 Minor tweaks
    [TestBoard.kicad_sch]
